Waleed99i/chipathon-2026-systolic-ip-core/README.md

# RTL-to-GDSII Design of a Configurable Matrix Accelerator IP on GF180MCU










## Overview

This project implements a configurable **NxN systolic matrix accelerator IP** targeting **GF180MCU**, following a complete **RTL-to-GDSII** design flow. The architecture consists of modular **Processing Elements (PEs)** built around an **approximate logarithmic MAC unit** to improve hardware efficiency.

The current design uses **FP16 inputs**, performs approximate floating-point multiplication, converts each product **directly to signed Q16.16**, and accumulates partial sums using a **32-bit Q16.16 accumulator**. The reusable RTL modules are parameterized, while the current ASIC implementation and physical verification cover a fixed **4×4 systolic array**. The approximate MAC has previously been demonstrated on the **Xilinx Nexys A7**; this is separate from validating the complete corrected ASIC implementation on FPGA.

---

## Design Specifications

| Specification | Details |
|---|---|
| Project Name | RTL-to-GDSII Design of a Configurable Matrix Accelerator IP on GF180MCU |
| Track | A |
| Team | A34 – SiliconForge |
| Target Technology | GlobalFoundries GF180MCU 180 nm, gf180mcuD |
| Hardware Description Language | Verilog / SystemVerilog |
| Target Flow | RTL verification → synthesis → physical design → block-level signoff → GDSII |
| Architecture | Parameterized RTL modules; current ASIC implementation fixed at 4×4 |
| Implemented Configuration | 4×4 Systolic Array |
| Compute Unit | Processing Element (PE) |
| Arithmetic Unit | Approximate Multiply-Accumulate (MAC) |
| Input Format | FP16 encoding (IEEE-754 half-precision format); arithmetic is approximate |
| Multiplier Output | FP16-encoded approximate logarithmic product |
| Converted Product | Signed Q16.16, converted directly from the FP16 product without an intermediate Q8.8 conversion |
| Accumulator / Result | Signed 32-bit Q16.16 |
| Interface | Fixed-cycle protocol: 8-bit input and 4-bit output; no external ready/valid handshake |
| Transaction Control | Reset before each matrix multiplication |
| Compute Schedule | 3N−2 = 10 internal compute events for N=4; not the complete external transaction latency |
| Clock Target | 45 ns (approximately 22.22 MHz) |
| FPGA Platform | Xilinx Nexys A7 — earlier approximate-MAC demonstration, separate from complete corrected-system validation |
| ASIC Top Cell | chip_core |
| Implemented Block Boundary | 1675 μm × 1675 μm; final shared-chip allocation subject to organizer confirmation |
| Logical Pad Definitions | 16 total: clock, reset, 8 inputs, 4 outputs, VDD and VSS; final package pin numbering pending |
| Optional Extension | Future work: lightweight open-source RISC-V integration |
---

## Project Goals

The primary objective of this project is to design a configurable systolic matrix accelerator IP capable of accelerating matrix multiplication workloads for machine learning and digital signal processing applications. The design emphasizes modularity, scalability, and hardware efficiency while following a complete ASIC design methodology.

Key design objectives include:

- Parameterized NxN systolic array architecture
- Modular Processing Element (PE) based design
- Approximate MAC implementation for reduced hardware complexity
- Fixed-cycle communication for the current chip wrapper; ready-valid interfacing remains a possible future extension
- RTL and gate-level verification, with earlier module-level FPGA demonstration
- Optional lightweight RISC-V integration
- OR integration with a ML Framework
- Tapeout-ready RTL targeting GF180MCU

---

# System Architecture

The accelerator consists of a parameterized systolic array built from Processing Elements (PEs). Each PE performs Multiply-Accumulate (MAC) operations while forwarding operands to neighboring PEs, enabling highly parallel matrix multiplication.

Current demonstrations are based on a **4×4 systolic array**, while the RTL is being developed to support configurable **NxN** array dimensions.

<div align="center">

**Top-Level Architecture**

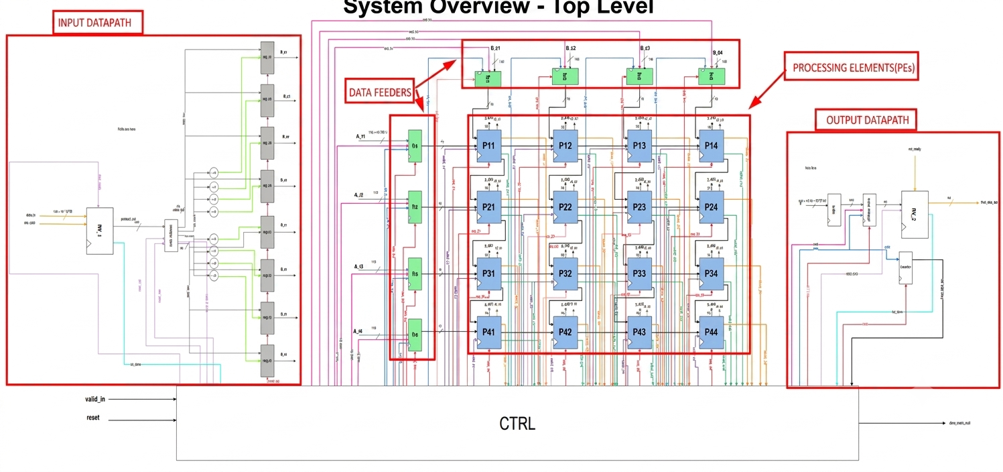
[picture p1: docs/systolic.png]
systolic


</div>

---

## Data Flow
```mermaid
flowchart TD

    A[Input Matrices A and B] --> B[Input Datapath]
    B --> C[Data Feeders]

    C --> D

    subgraph D["Parameterized NxN Systolic Array"]
        direction TB
        E[Processing Elements]
    end

    D --> F[Output Datapath]
    F --> G[Output Matrix]

    style A fill:#1e293b,stroke:#60a5fa,stroke-width:2px,color:#fff
    style B fill:#1e293b,stroke:#60a5fa,stroke-width:2px,color:#fff
    style C fill:#1e293b,stroke:#60a5fa,stroke-width:2px,color:#fff
    style D fill:#0f172a,stroke:#38bdf8,stroke-width:3px,color:#fff
    style E fill:#334155,stroke:#94a3b8,stroke-width:2px,color:#fff
    style F fill:#1e293b,stroke:#60a5fa,stroke-width:2px,color:#fff
    style G fill:#064e3b,stroke:#34d399,stroke-width:3px,color:#fff

    linkStyle default stroke:#64748b,stroke-width:2px
```

and will do integration afterwards with riscv core or ML framework

---
# Major Hardware Blocks

| Block | Inputs | Outputs | Description |
|---|---|---|---|
| **MAC Unit** | FP16, FP16 | Q16.16 | Performs approximate logarithmic multiplication on two FP16 operands, converts the product to fixed-point, and accumulates the result using a 32-bit Q16.16 accumulator. |
| **Processing Element (PE)** | FP16 activation, FP16 weight | FP16 activation, FP16 weight, Q16.16 partial sum | Core computational element of the systolic array. Each PE performs one MAC operation while forwarding activations and weights to neighboring PEs. |
| **Input Datapath** | **16 × 2N** | **16 × (2N-1)** | Accepts the external input stream, separates activations and weights, and prepares row and column data streams for the Data Feeders. |
| **Data Feeders** | **16 × (2N-1)** | **FP16 streams** | Aligns and schedules incoming operands with appropriate delays before injecting them into the systolic array. |
| **Chip Wrapper** | Clock, reset, 8-bit input | 4-bit output | Transfers input bytes and output nibbles on a fixed schedule, with no external ready/valid handshake. Reset is required before each matrix. |
| **Output Datapath** | **32 × (N × N)** | **64** | Collects the final outputs from every Processing Element and formats the result matrix for external transfer. |
| **Register** | Data, Clock, Reset | Registered Data | Pipeline register with reset logic and multiplexing support. Stores intermediate values between clock cycles. |
| **Counter** | Clock, Reset, done | valid_out | Controls the compute-event schedule using COUNT_MAX = 3N−2, which is 10 for N=4. This is an internal compute schedule, not the complete chip transaction latency. |

In Our Example N=4 since 4x4 systolic

---

# Chip Information

| Item | Value |
|---|---|
| Implemented Block | chip_core |
| Final Shared-Chip Allocation | Subject to organizer confirmation |
| Implemented Block Boundary | 1675 μm × 1675 μm |
| Logical Signal Pads | 14: clock, reset, 8 inputs and 4 outputs |
| Power/Ground Definitions | VDD and VSS |
| Package Pin Numbering | Pending final package and padframe |

---

# Pin Configuration

| Signal | Direction | Description |
|---|---|---|
| clk | Input | System clock |
| rst_n | Input | Active-low reset; reset before each matrix |
| input_in_0 … input_in_7 | Input | Eight-bit input data bus |
| output_out_0 … output_out_3 | Output function | Four-bit output bus, using bidirectional pad cells |
| VDD | Power | Block supply |
| VSS | Ground | Block ground |

See [info.yaml](info.yaml) for pad definitions and [TEST_PLAN.md](TEST_PLAN.md) for the verified fixed-cycle protocol.

---

# Interfacing

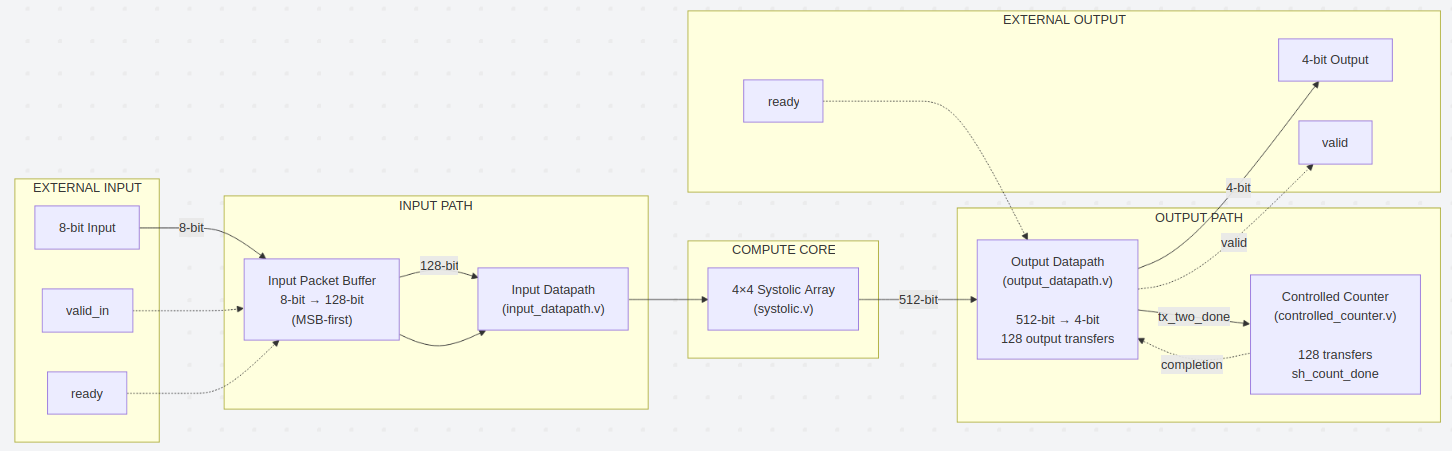
[picture p2: docs/Implementation/interfacing.png]
integration


---

# Design Flow

The development follows a structured hardware design methodology beginning from architecture definition and RTL implementation, progressing through verification and FPGA validation, and culminating in an ASIC RTL-to-GDSII flow targeting GF180MCU.

```mermaid
flowchart LR

    A[Architecture Design]
    B[RTL Development]
    C[Module Verification]
    D[System Integration]
    E[FPGA Validation]
    F[RTL Synthesis]
    G[Physical Design]
    H[Signoff Verification]
    I[GDSII Generation]

    A --> B
    B --> C
    C --> D
    D --> E
    E --> F
    F --> G
    G --> H
    H --> I

    A:::s1
    B:::s2
    C:::s3
    D:::s4
    E:::s5
    F:::s6
    G:::s7
    H:::s8
    I:::s9

    classDef s1 fill:#172554,stroke:#3b82f6,stroke-width:2px,color:#fff;
    classDef s2 fill:#1e3a8a,stroke:#60a5fa,stroke-width:2px,color:#fff;
    classDef s3 fill:#312e81,stroke:#818cf8,stroke-width:2px,color:#fff;
    classDef s4 fill:#4c1d95,stroke:#a78bfa,stroke-width:2px,color:#fff;
    classDef s5 fill:#581c87,stroke:#c084fc,stroke-width:2px,color:#fff;
    classDef s6 fill:#701a75,stroke:#e879f9,stroke-width:2px,color:#fff;
    classDef s7 fill:#831843,stroke:#f472b6,stroke-width:2px,color:#fff;
    classDef s8 fill:#9f1239,stroke:#fb7185,stroke-width:2px,color:#fff;
    classDef s9 fill:#064e3b,stroke:#34d399,stroke-width:3px,color:#fff;

    linkStyle default stroke:#94a3b8,stroke-width:2px;
```

---

# Development Roadmap

The project follows a structured four-phase implementation strategy, progressing from RTL development to ASIC implementation.

| Phase | Objectives | Status |
|---|---|---|
| **Phase 1** | Approximate MAC, Processing Element (PE), Parameterized Systolic Array RTL, Functional Verification | Completed |
| **Phase 2** | Input/Output Datapaths, Data Feeders, Fixed-Cycle Chip Wrapper, System Integration | Completed |
| **Phase 3** | FPGA Synthesis & Validation, Performance Optimization | In Progress |
| **Phase 4** | Corrected block implementation and verification completed; shared-chip integration/fabrication | In Progress | 

---

# Current Progress

A detailed project tracker is available here:

[Progress Tracker](https://docs.google.com/spreadsheets/d/1-T_ZC2E8IlozA7BDgOPqUjp5dZac3WXzmJ67Tr54c2c/edit?usp=sharing)

---
# Chip_core - Overall RTL Breakdown

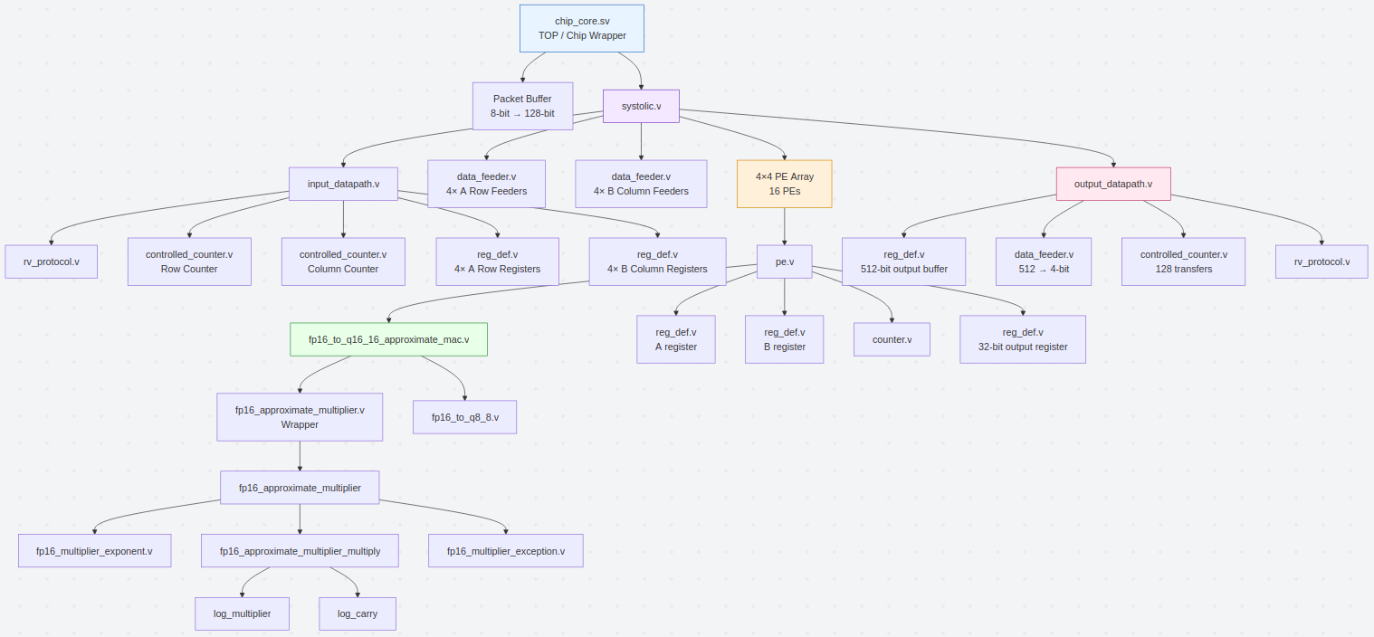
[picture p3: docs/chip_core.png]
chip_core


---

# Success Metrics

The project will be considered successful upon meeting the following objectives.

| Metric | Target |
|---|---|
| Functional Correctness | Complete matrix multiplication verified through simulation and FPGA validation |
| Frequency | Meet timing for the target GF180MCU implementation |
| Area | Current implemented boundary: **1675 μm × 1675 μm**; final shared-chip allocation subject to organizer confirmation |
| Throughput | Sustain one MAC operation per Processing Element per clock after pipeline fill |
| Scalability | Support parameterized NxN systolic arrays |
| FPGA Validation | Successful implementation on Xilinx Nexys A7 |
| ASIC Flow | Successful RTL-to-GDSII implementation using GF180MCU |

---

# FPGA Validation

The Approximate MAC architecture has been synthesized and validated on the **Xilinx Nexys A7 FPGA**.

Future FPGA validation includesComplete Synthesis of Systolic Array

---

# ASIC Design Flow

The project targets a complete RTL-to-GDSII implementation using the **GF180MCU** technology.

The completed block-level backend flow includes:

- RTL Synthesis
- Static Timing Analysis
- Floorplanning
- Power Planning
- Placement
- Clock Tree Synthesis
- Routing
- DRC
- LVS
- Signoff
- GDSII Generation
---

# Physical Design Results

The corrected 4×4 accelerator was implemented using **LibreLane 3.0.0** on the **GF180MCU 180 nm process (gf180mcuD)**. The implementation includes the counter and input-datapath corrections, direct FP16-to-Q16.16 product conversion, and a seven-cell physical engineering change order (ECO).

## Current Block-Level Signoff: chip_core

| Metric | Result |
|---|---|
| Clock period | 45 ns (approximately 22.22 MHz) |
| Setup timing | 0 violations across all 9 analyzed corners; worst setup slack **+0.5499 ns** |
| Hold timing | 0 violations across all 9 analyzed corners; worst hold slack **+0.0912 ns** |
| DRC | Pass: 0 reported errors in Magic and KLayout |
| LVS | Pass: layout and powered netlist match |
| Antenna | Pass: 0 reported violations |
| Max slew violations | 0 across all 9 analyzed corners |
| Max fanout violations | 0 across all 9 analyzed corners |
| Max capacitance violations | 0 across all 9 analyzed corners |
| Block boundary | 1675 μm × 1675 μm |
| Standard-cell instance area | Approximately 0.987 mm² |
| Standard-cell utilization | Approximately 36.17% |

The seven-cell ECO cleared the remaining slew and capacitance violations. Placement legalization, routing, parasitic extraction and block-level signoff checks were rerun after the cell changes.

Reproducibility was verified in two stages: an RTL-to-checkpoint rebuild produced a byte-identical checkpoint, and a checkpoint-to-GDS replay reproduced the powered netlist byte-for-byte and the GDS polygon geometry and labels across all 27 layers. GDS file bytes differed.

These are pre-silicon, block-level results under the recorded constraints and tool/PDK environment. 

## Early Flow Validation (Workshop/Padring Baseline)

Before integrating the real accelerator, the LibreLane/GF180MCU toolchain was validated end-to-end on a placeholder design:

| Clock Period | Frequency | DRC | LVS | Setup Slack (worst corner) |
|---|---|---|---|---|
| 40ns | 25 MHz |  Pass |  Pass | — |
| 30ns | 33 MHz |  Pass |  Pass | +13.99ns |

These results validate the tool/PDK flow only; they are not timing results for the integrated accelerator (see Current Block-Level Signoff above).

## Test Plan and Reproducibility

- [Silicon test plan](TEST_PLAN.md): fixed-cycle pin timing, bring-up tests, pass/fail criteria, equipment requirements and publication of measured results.
- [Pin-level verification](test/sim_results/20261031_095426/SUMMARY.txt): 93 matrix transactions passed on both RTL and the final gate-level netlist, with zero mismatches. Deliberately incorrect vectors were detected.
- [Reproduction guide](reproduce/README.md): the RTL-to-checkpoint rebuild produced a byte-identical checkpoint. The checkpoint-to-GDS replay produced a byte-identical powered netlist and matching GDS geometry and labels across all 27 layers.

The two reproduction stages used the existing Nix environment and local PDK. Independent tool/PDK installation has not been demonstrated. Approximate arithmetic, finite numerical range and reset-per-matrix operation remain documented limitations.

## Submission
`info.yaml` and `lvs_config.json` reference the final `chip_core` design. GDS output (45ns, fully timing-closed, DRC/LVS/Antenna clean) is included at `gds/chip_core.gds`.

---

# Resources Links
[Github Repository](https://github.com/Waleed99i/chipathon-2026-systolic-ip-core)

[Padring Proposal Slide Link](https://docs.google.com/presentation/d/1hGlZvZFFLWlx8hJLkmKaFUCYW1uyk7dkF3z44zS5dTQ/edit?usp=sharing)

[Proposal Slide Link](https://docs.google.com/presentation/d/1u3HMhi0KsbPWeEo2SdxVy66h3A2EKqcJ1DBfrJLO6gw/edit?usp=sharing)

[Detailed Proposal Link](https://docs.google.com/document/d/1xj1mtmIwVFShTZUq7PKGKg6W1PffVR4_vp0zMOgc8iE/edit?usp=sharing)

[Pin Requirements Link](https://docs.google.com/spreadsheets/d/1KH9oZjetv38rxIAL1lnZPNvuW3Qhh9-GSiZVkqRqzDc/edit?usp=sharing)

[Progress Tracker](https://docs.google.com/spreadsheets/d/1-T_ZC2E8IlozA7BDgOPqUjp5dZac3WXzmJ67Tr54c2c/edit?usp=sharing)

[Propsal Presentation Video Link](https://youtu.be/i-fauhB5LK8)

[schematic Review Slides (Extended) Link](https://docs.google.com/presentation/d/1XbPeDPZbSCVIkTJ6YJzha1Qlfp463J90a_zdM6emGkA/edit?usp=sharing)

[Schematic Review Slides (Abbreviated) Link](https://docs.google.com/presentation/d/1Jb6dxnFrmxyFip32HSGO6qTabfnJVp7GGHKu2foIoVM/edit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)

[Schematic Review Presentation Video Link](https://youtu.be/ZGd18GQEK7I?si=cJApcDfwtI_DK_bS)

[Layout Review slide Link](https://docs.google.com/presentation/d/1ikT-gyHuk3Rm3eCD9rJ-7HMOGe7eNcvOWRMagcxCcSo/edit?usp=sharing)

[Layout Review Presentation Video Link](https://drive.google.com/file/d/1sBQsk-xMmFBTl1YXC0w8MSAxI7oVKdcV/view?usp=drive_link)

---

# Team

| Member | GitHub | Discord | Affiliation | Role |
|---|---|---|---|---|
| Muhammad Waleed Akram | [@Waleed99i](https://github.com/Waleed99i) | `waleed_07` | University of Engineering and Technology, Lahore (Undergraduate) | Team Lead |
| Abdul Muiz | [@abdmz162](https://github.com/abdmz162) | `abdmz` | University of Engineering and Technology, Lahore (Undergraduate) | RTL Designer |
| Rumali Siddiqua | [@Rumali-Siddiqua](https://github.com/Rumali-Siddiqua) | `rumali24` | University of Virginia, USA (PhD Student) | Physical Designer |
| Nur Cahyo Ihsan Prastyawan | [@cprastyawan](https://github.com/cprastyawan) | `chyp2640` | Universitas Gadjah Mada, Indonesia (Master's Graduate) | RTL Designer |

---

# License

This project is licensed under the Apache License 2.0.

See the **LICENSE** file for details.
