Waleed99i/chipathon-2026-systolic-ip-core/Project Proposal/phased_implementation.md

We have divided our proposed implementation into below 4 phases : 

### Phase 1: Core Systolic Array
- Design of MAC and Processing Element (PE)
- Parameterized systolic array implementation
- RTL development and modular architecture
- Testbench development and verification

### Phase 2: Memory and Integration
- SRAM buffering system
- Streaming and data movement architecture
- Integration of control logic and datapath

### Phase 3: FPGA and Optimization
- FPGA synthesis and deployment
- Performance and timing analysis
- Initial optimization techniques

### Phase 4: ASIC Backend Flow
- RTL-to-GDSII implementation
- Floorplanning and placement
- Clock tree synthesis and routing
- Timing closure and signoff preparation
- Tapeout readiness exploration
