Waleed99i/chipathon-2026-systolic-ip-core/signoff/q16_eco_full4/run_reports/final/metrics.csv

Metric | Value
design__instance__displacement__total | 35.84
design__instance__displacement__mean | 0.0005
design__instance__displacement__max | 9.52
route__wirelength__estimated | 1.34462E+6
design__violations | 0
design__io | 72
design__die__area | 2.80562E+6
design__core__area | 2.72901E+6
design__instance__count | 119247
design__instance__area | 2.72901E+6
design__instance__count__stdcell | 52630
design__instance__area__stdcell | 987181
design__instance__count__macros | 0
design__instance__area__macros | 0
design__instance__count__padcells | 0
design__instance__area__padcells | 0
design__instance__count__cover | 0
design__instance__area__cover | 0
design__instance__utilization | 0.361736
design__instance__utilization__stdcell | 0.361736
design__rows | 419
design__rows:GF018hv5v_mcu_sc7 | 419
design__sites | 1243173
design__sites:GF018hv5v_mcu_sc7 | 1243173
design__instance__count__class:endcap_cell | 838
design__instance__area__class:endcap_cell | 3679.16
design__instance__count__class:tap_cell | 17688
design__instance__area__class:tap_cell | 77657.4
design__instance__count__class:antenna_cell | 14
design__instance__area__class:antenna_cell | 61.4656
design__instance__count__class:tie_cell | 52
design__instance__area__class:tie_cell | 456.602
design__instance__count__class:clock_buffer | 1060
design__instance__area__class:clock_buffer | 48777.3
design__instance__count__class:timing_repair_buffer | 4878
design__instance__area__class:timing_repair_buffer | 132371
design__instance__count__class:inverter | 2170
design__instance__area__class:inverter | 19142.1
design__instance__count__class:clock_inverter | 84
design__instance__area__class:clock_inverter | 1356.63
design__instance__count__class:sequential_cell | 4096
design__instance__area__class:sequential_cell | 288601
design__instance__count__class:multi_input_combinational_cell | 21750
design__instance__area__class:multi_input_combinational_cell | 415079
flow__warnings__count | 1
flow__errors__count | 0
flow__warnings__count:ORD-2001 | 1
flow__warnings__type_count | 1
design__max_slew_violation__count__corner:nom_tt_025C_5v00 | 0
design__max_fanout_violation__count__corner:nom_tt_025C_5v00 | 0
design__max_cap_violation__count__corner:nom_tt_025C_5v00 | 0
power__internal__total | 0.1038675308227539
power__switching__total | 0.03214292228221893
power__leakage__total | 0.000012093365512555465
power__total | 0.13602255284786224
clock__skew__worst_hold__corner:nom_tt_025C_5v00 | -0.5598430766323693
clock__skew__worst_setup__corner:nom_tt_025C_5v00 | 0.5658276229935633
timing__hold__ws__corner:nom_tt_025C_5v00 | 0.2871001295741329
timing__setup__ws__corner:nom_tt_025C_5v00 | 18.819042856719385
timing__hold__tns__corner:nom_tt_025C_5v00 | 0.0
timing__setup__tns__corner:nom_tt_025C_5v00 | 0.0
timing__hold__wns__corner:nom_tt_025C_5v00 | 0
timing__setup__wns__corner:nom_tt_025C_5v00 | 0.0
timing__hold_vio__count__corner:nom_tt_025C_5v00 | 0
timing__hold_r2r__ws__corner:nom_tt_025C_5v00 | 0.287100
timing__hold_r2r_vio__count__corner:nom_tt_025C_5v00 | 0
timing__setup_vio__count__corner:nom_tt_025C_5v00 | 0
timing__setup_r2r__ws__corner:nom_tt_025C_5v00 | 21.393702
timing__setup_r2r_vio__count__corner:nom_tt_025C_5v00 | 0
flow__warnings__count:EST-0026 | 15
design__max_slew_violation__count | 0
design__max_fanout_violation__count | 0
design__max_cap_violation__count | 0
clock__skew__worst_hold | -0.4476421304780765
clock__skew__worst_setup | 0.4497588817566926
timing__hold__ws | 0.09115441992566169
timing__setup__ws | 0.5498535116188729
timing__hold__tns | 0.0
timing__setup__tns | 0.0
timing__hold__wns | 0
timing__setup__wns | 0.0
timing__hold_vio__count | 0
timing__hold_r2r__ws | 0.091154
timing__hold_r2r_vio__count | 0
timing__setup_vio__count | 0
timing__setup_r2r__ws | 0.549854
timing__setup_r2r_vio__count | 0
global_route__vias | 19
global_route__wirelength | 2175969
antenna__violating__nets | 0
antenna__violating__pins | 0
route__antenna_violation__count | 0
antenna_diodes_count | 12
route__net | 33613
route__net__special | 2
route__drc_errors__iter:0 | 10
route__wirelength__iter:0 | 1437134
route__drc_errors__iter:1 | 0
route__wirelength__iter:1 | 1437128
route__drc_errors__iter:2 | 21
route__wirelength__iter:2 | 1437202
route__drc_errors__iter:3 | 0
route__wirelength__iter:3 | 1437123
route__drc_errors__iter:4 | 11
route__wirelength__iter:4 | 1437154
route__drc_errors__iter:5 | 11
route__wirelength__iter:5 | 1437154
route__drc_errors__iter:6 | 9
route__wirelength__iter:6 | 1437155
route__drc_errors__iter:7 | 9
route__wirelength__iter:7 | 1437150
route__drc_errors__iter:8 | 9
route__wirelength__iter:8 | 1437159
route__drc_errors__iter:10 | 9
route__wirelength__iter:10 | 1437158
route__drc_errors__iter:11 | 9
route__wirelength__iter:11 | 1437155
route__drc_errors__iter:15 | 9
route__wirelength__iter:15 | 1437159
route__drc_errors__iter:16 | 9
route__wirelength__iter:16 | 1437162
route__drc_errors__iter:17 | 19
route__wirelength__iter:17 | 1437152
route__drc_errors__iter:18 | 12
route__wirelength__iter:18 | 1437153
route__drc_errors__iter:19 | 12
route__wirelength__iter:19 | 1437154
route__drc_errors__iter:20 | 12
route__wirelength__iter:20 | 1437159
route__drc_errors__iter:21 | 7
route__wirelength__iter:21 | 1437157
route__drc_errors__iter:22 | 7
route__wirelength__iter:22 | 1437158
route__drc_errors__iter:23 | 7
route__wirelength__iter:23 | 1437158
route__drc_errors__iter:24 | 7
route__wirelength__iter:24 | 1437158
route__drc_errors__iter:25 | 17
route__wirelength__iter:25 | 1437155
route__drc_errors__iter:26 | 10
route__wirelength__iter:26 | 1437158
route__drc_errors__iter:27 | 10
route__wirelength__iter:27 | 1437158
route__drc_errors__iter:28 | 1
route__wirelength__iter:28 | 1437150
route__drc_errors__iter:29 | 1
route__wirelength__iter:29 | 1437146
route__drc_errors__iter:30 | 0
route__wirelength__iter:30 | 1437146
route__drc_errors | 0
route__wirelength | 1437128
route__vias | 211229
route__vias__singlecut | 211229
route__vias__multicut | 0
flow__warnings__count:DRT-0349 | 8
design__disconnected_pin__count | 4
design__critical_disconnected_pin__count | 0
flow__warnings__count:ORD-0039 | 1
route__wirelength__max | 1257.62
design__instance__count__class:fill_cell | 66617
design__instance__area__class:fill_cell | 1.74183E+6
timing__unannotated_net__count__corner:nom_tt_025C_5v00 | 495
timing__unannotated_net_filtered__count__corner:nom_tt_025C_5v00 | 0
design__max_slew_violation__count__corner:nom_ss_125C_4v50 | 0
design__max_fanout_violation__count__corner:nom_ss_125C_4v50 | 0
design__max_cap_violation__count__corner:nom_ss_125C_4v50 | 0
clock__skew__worst_hold__corner:nom_ss_125C_4v50 | -0.8046048499650114
clock__skew__worst_setup__corner:nom_ss_125C_4v50 | 0.8146124005920153
timing__hold__ws__corner:nom_ss_125C_4v50 | 0.7057741257853857
timing__setup__ws__corner:nom_ss_125C_4v50 | 1.2720314051016304
timing__hold__tns__corner:nom_ss_125C_4v50 | 0.0
timing__setup__tns__corner:nom_ss_125C_4v50 | 0.0
timing__hold__wns__corner:nom_ss_125C_4v50 | 0
timing__setup__wns__corner:nom_ss_125C_4v50 | 0.0
timing__hold_vio__count__corner:nom_ss_125C_4v50 | 0
timing__hold_r2r__ws__corner:nom_ss_125C_4v50 | 0.705774
timing__hold_r2r_vio__count__corner:nom_ss_125C_4v50 | 0
timing__setup_vio__count__corner:nom_ss_125C_4v50 | 0
timing__setup_r2r__ws__corner:nom_ss_125C_4v50 | 1.272031
timing__setup_r2r_vio__count__corner:nom_ss_125C_4v50 | 0
timing__unannotated_net__count__corner:nom_ss_125C_4v50 | 495
timing__unannotated_net_filtered__count__corner:nom_ss_125C_4v50 | 0
design__max_slew_violation__count__corner:nom_ff_n40C_5v50 | 0
design__max_fanout_violation__count__corner:nom_ff_n40C_5v50 | 0
design__max_cap_violation__count__corner:nom_ff_n40C_5v50 | 0
clock__skew__worst_hold__corner:nom_ff_n40C_5v50 | -0.4515758728101822
clock__skew__worst_setup__corner:nom_ff_n40C_5v50 | 0.45477131681003163
timing__hold__ws__corner:nom_ff_n40C_5v50 | 0.09316636614778911
timing__setup__ws__corner:nom_ff_n40C_5v50 | 25.393261545570383
timing__hold__tns__corner:nom_ff_n40C_5v50 | 0.0
timing__setup__tns__corner:nom_ff_n40C_5v50 | 0.0
timing__hold__wns__corner:nom_ff_n40C_5v50 | 0
timing__setup__wns__corner:nom_ff_n40C_5v50 | 0.0
timing__hold_vio__count__corner:nom_ff_n40C_5v50 | 0
timing__hold_r2r__ws__corner:nom_ff_n40C_5v50 | 0.093166
timing__hold_r2r_vio__count__corner:nom_ff_n40C_5v50 | 0
timing__setup_vio__count__corner:nom_ff_n40C_5v50 | 0
timing__setup_r2r__ws__corner:nom_ff_n40C_5v50 | 30.448641
timing__setup_r2r_vio__count__corner:nom_ff_n40C_5v50 | 0
timing__unannotated_net__count__corner:nom_ff_n40C_5v50 | 495
timing__unannotated_net_filtered__count__corner:nom_ff_n40C_5v50 | 0
design__max_slew_violation__count__corner:min_tt_025C_5v00 | 0
design__max_fanout_violation__count__corner:min_tt_025C_5v00 | 0
design__max_cap_violation__count__corner:min_tt_025C_5v00 | 0
clock__skew__worst_hold__corner:min_tt_025C_5v00 | -0.5558125228497782
clock__skew__worst_setup__corner:min_tt_025C_5v00 | 0.558321182867171
timing__hold__ws__corner:min_tt_025C_5v00 | 0.28394132293513225
timing__setup__ws__corner:min_tt_025C_5v00 | 19.424050473404662
timing__hold__tns__corner:min_tt_025C_5v00 | 0.0
timing__setup__tns__corner:min_tt_025C_5v00 | 0.0
timing__hold__wns__corner:min_tt_025C_5v00 | 0
timing__setup__wns__corner:min_tt_025C_5v00 | 0.0
timing__hold_vio__count__corner:min_tt_025C_5v00 | 0
timing__hold_r2r__ws__corner:min_tt_025C_5v00 | 0.283941
timing__hold_r2r_vio__count__corner:min_tt_025C_5v00 | 0
timing__setup_vio__count__corner:min_tt_025C_5v00 | 0
timing__setup_r2r__ws__corner:min_tt_025C_5v00 | 21.750294
timing__setup_r2r_vio__count__corner:min_tt_025C_5v00 | 0
timing__unannotated_net__count__corner:min_tt_025C_5v00 | 495
timing__unannotated_net_filtered__count__corner:min_tt_025C_5v00 | 0
design__max_slew_violation__count__corner:min_ss_125C_4v50 | 0
design__max_fanout_violation__count__corner:min_ss_125C_4v50 | 0
design__max_cap_violation__count__corner:min_ss_125C_4v50 | 0
clock__skew__worst_hold__corner:min_ss_125C_4v50 | -0.7981837638981886
clock__skew__worst_setup__corner:min_ss_125C_4v50 | 0.8018936852621997
timing__hold__ws__corner:min_ss_125C_4v50 | 0.700570288277188
timing__setup__ws__corner:min_ss_125C_4v50 | 1.7366553131556215
timing__hold__tns__corner:min_ss_125C_4v50 | 0.0
timing__setup__tns__corner:min_ss_125C_4v50 | 0.0
timing__hold__wns__corner:min_ss_125C_4v50 | 0
timing__setup__wns__corner:min_ss_125C_4v50 | 0.0
timing__hold_vio__count__corner:min_ss_125C_4v50 | 0
timing__hold_r2r__ws__corner:min_ss_125C_4v50 | 0.700570
timing__hold_r2r_vio__count__corner:min_ss_125C_4v50 | 0
timing__setup_vio__count__corner:min_ss_125C_4v50 | 0
timing__setup_r2r__ws__corner:min_ss_125C_4v50 | 1.736655
timing__setup_r2r_vio__count__corner:min_ss_125C_4v50 | 0
timing__unannotated_net__count__corner:min_ss_125C_4v50 | 495
timing__unannotated_net_filtered__count__corner:min_ss_125C_4v50 | 0
design__max_slew_violation__count__corner:min_ff_n40C_5v50 | 0
design__max_fanout_violation__count__corner:min_ff_n40C_5v50 | 0
design__max_cap_violation__count__corner:min_ff_n40C_5v50 | 0
clock__skew__worst_hold__corner:min_ff_n40C_5v50 | -0.4476421304780765
clock__skew__worst_setup__corner:min_ff_n40C_5v50 | 0.4497588817566926
timing__hold__ws__corner:min_ff_n40C_5v50 | 0.09115441992566169
timing__setup__ws__corner:min_ff_n40C_5v50 | 25.799576538721972
timing__hold__tns__corner:min_ff_n40C_5v50 | 0.0
timing__setup__tns__corner:min_ff_n40C_5v50 | 0.0
timing__hold__wns__corner:min_ff_n40C_5v50 | 0
timing__setup__wns__corner:min_ff_n40C_5v50 | 0.0
timing__hold_vio__count__corner:min_ff_n40C_5v50 | 0
timing__hold_r2r__ws__corner:min_ff_n40C_5v50 | 0.091154
timing__hold_r2r_vio__count__corner:min_ff_n40C_5v50 | 0
timing__setup_vio__count__corner:min_ff_n40C_5v50 | 0
timing__setup_r2r__ws__corner:min_ff_n40C_5v50 | 30.643335
timing__setup_r2r_vio__count__corner:min_ff_n40C_5v50 | 0
timing__unannotated_net__count__corner:min_ff_n40C_5v50 | 495
timing__unannotated_net_filtered__count__corner:min_ff_n40C_5v50 | 0
design__max_slew_violation__count__corner:max_tt_025C_5v00 | 0
design__max_fanout_violation__count__corner:max_tt_025C_5v00 | 0
design__max_cap_violation__count__corner:max_tt_025C_5v00 | 0
clock__skew__worst_hold__corner:max_tt_025C_5v00 | -0.5662390716581259
clock__skew__worst_setup__corner:max_tt_025C_5v00 | 0.5746183691511645
timing__hold__ws__corner:max_tt_025C_5v00 | 0.2908171563657026
timing__setup__ws__corner:max_tt_025C_5v00 | 18.10364709384127
timing__hold__tns__corner:max_tt_025C_5v00 | 0.0
timing__setup__tns__corner:max_tt_025C_5v00 | 0.0
timing__hold__wns__corner:max_tt_025C_5v00 | 0
timing__setup__wns__corner:max_tt_025C_5v00 | 0.0
timing__hold_vio__count__corner:max_tt_025C_5v00 | 0
timing__hold_r2r__ws__corner:max_tt_025C_5v00 | 0.290817
timing__hold_r2r_vio__count__corner:max_tt_025C_5v00 | 0
timing__setup_vio__count__corner:max_tt_025C_5v00 | 0
timing__setup_r2r__ws__corner:max_tt_025C_5v00 | 20.966507
timing__setup_r2r_vio__count__corner:max_tt_025C_5v00 | 0
timing__unannotated_net__count__corner:max_tt_025C_5v00 | 495
timing__unannotated_net_filtered__count__corner:max_tt_025C_5v00 | 0
design__max_slew_violation__count__corner:max_ss_125C_4v50 | 0
design__max_fanout_violation__count__corner:max_ss_125C_4v50 | 0
design__max_cap_violation__count__corner:max_ss_125C_4v50 | 0
clock__skew__worst_hold__corner:max_ss_125C_4v50 | -0.8128729031078363
clock__skew__worst_setup__corner:max_ss_125C_4v50 | 0.829850878169784
timing__hold__ws__corner:max_ss_125C_4v50 | 0.711956291850552
timing__setup__ws__corner:max_ss_125C_4v50 | 0.5498535116188729
timing__hold__tns__corner:max_ss_125C_4v50 | 0.0
timing__setup__tns__corner:max_ss_125C_4v50 | 0.0
timing__hold__wns__corner:max_ss_125C_4v50 | 0
timing__setup__wns__corner:max_ss_125C_4v50 | 0.0
timing__hold_vio__count__corner:max_ss_125C_4v50 | 0
timing__hold_r2r__ws__corner:max_ss_125C_4v50 | 0.711956
timing__hold_r2r_vio__count__corner:max_ss_125C_4v50 | 0
timing__setup_vio__count__corner:max_ss_125C_4v50 | 0
timing__setup_r2r__ws__corner:max_ss_125C_4v50 | 0.549854
timing__setup_r2r_vio__count__corner:max_ss_125C_4v50 | 0
timing__unannotated_net__count__corner:max_ss_125C_4v50 | 495
timing__unannotated_net_filtered__count__corner:max_ss_125C_4v50 | 0
design__max_slew_violation__count__corner:max_ff_n40C_5v50 | 0
design__max_fanout_violation__count__corner:max_ff_n40C_5v50 | 0
design__max_cap_violation__count__corner:max_ff_n40C_5v50 | 0
clock__skew__worst_hold__corner:max_ff_n40C_5v50 | -0.45619573299091093
clock__skew__worst_setup__corner:max_ff_n40C_5v50 | 0.4608371314989266
timing__hold__ws__corner:max_ff_n40C_5v50 | 0.09556089523502256
timing__setup__ws__corner:max_ff_n40C_5v50 | 24.91069110386037
timing__hold__tns__corner:max_ff_n40C_5v50 | 0.0
timing__setup__tns__corner:max_ff_n40C_5v50 | 0.0
timing__hold__wns__corner:max_ff_n40C_5v50 | 0
timing__setup__wns__corner:max_ff_n40C_5v50 | 0.0
timing__hold_vio__count__corner:max_ff_n40C_5v50 | 0
timing__hold_r2r__ws__corner:max_ff_n40C_5v50 | 0.095561
timing__hold_r2r_vio__count__corner:max_ff_n40C_5v50 | 0
timing__setup_vio__count__corner:max_ff_n40C_5v50 | 0
timing__setup_r2r__ws__corner:max_ff_n40C_5v50 | 30.193577
timing__setup_r2r_vio__count__corner:max_ff_n40C_5v50 | 0
timing__unannotated_net__count__corner:max_ff_n40C_5v50 | 495
timing__unannotated_net_filtered__count__corner:max_ff_n40C_5v50 | 0
timing__unannotated_net__count | 495
timing__unannotated_net_filtered__count | 0
design_powergrid__voltage__worst__net:VDD__corner:nom_tt_025C_5v00 | 4.99919
design_powergrid__drop__average__net:VDD__corner:nom_tt_025C_5v00 | 4.99985
design_powergrid__drop__worst__net:VDD__corner:nom_tt_025C_5v00 | 0.000806911
design_powergrid__voltage__worst__net:VSS__corner:nom_tt_025C_5v00 | 0.000808328
design_powergrid__drop__average__net:VSS__corner:nom_tt_025C_5v00 | 0.000148739
design_powergrid__drop__worst__net:VSS__corner:nom_tt_025C_5v00 | 0.000808328
design_powergrid__voltage__worst | 0.000808328
design_powergrid__voltage__worst__net:VDD | 4.99919
design_powergrid__drop__worst | 0.000808328
design_powergrid__drop__worst__net:VDD | 0.000806911
design_powergrid__voltage__worst__net:VSS | 0.000808328
design_powergrid__drop__worst__net:VSS | 0.000808328
ir__voltage__worst | 5
ir__drop__avg | 0.00015200000000000000836830604811211742344312369823455810546875
ir__drop__worst | 0.0008069999999999999916455717396956970333121716976165771484375
design__xor_difference__count | 0
magic__drc_error__count | 0
klayout__drc_error__count | 0
magic__illegal_overlap__count | 0
design__lvs_device_difference__count | 0
design__lvs_net_difference__count | 0
design__lvs_property_fail__count | 0
design__lvs_error__count | 0
design__lvs_unmatched_device__count | 0
design__lvs_unmatched_net__count | 0
design__lvs_unmatched_pin__count | 0
