Waleed99i/chipathon-2026-systolic-ip-core/docs/simulations/counter.png

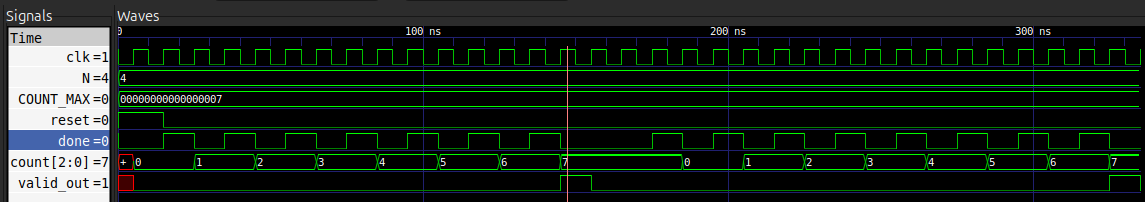
docs/simulations/counter.png
