Waleed99i/chipathon-2026-systolic-ip-core/docs/simulations/data_feeder.png

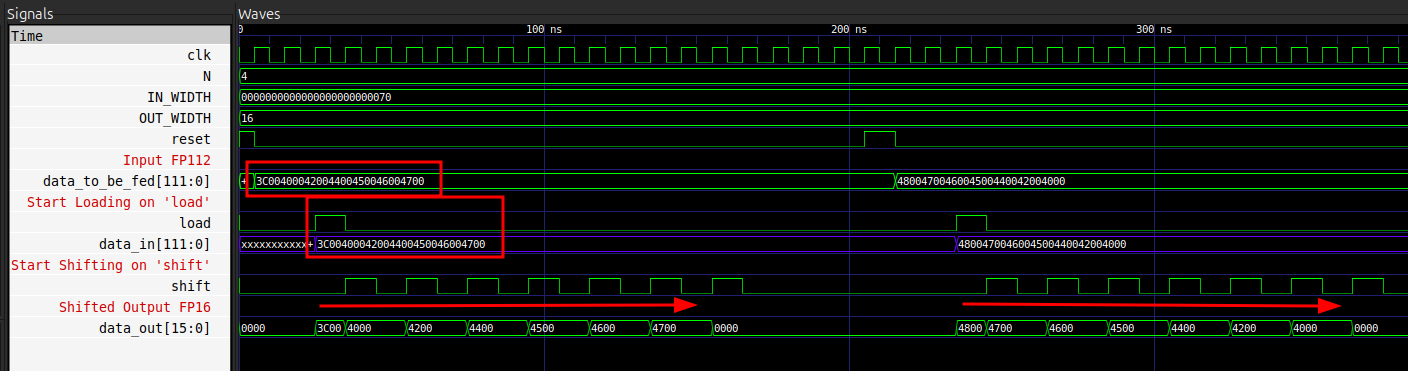
docs/simulations/data_feeder.png
