Waleed99i/chipathon-2026-systolic-ip-core/docs/simulations/input_datapath_explained.png

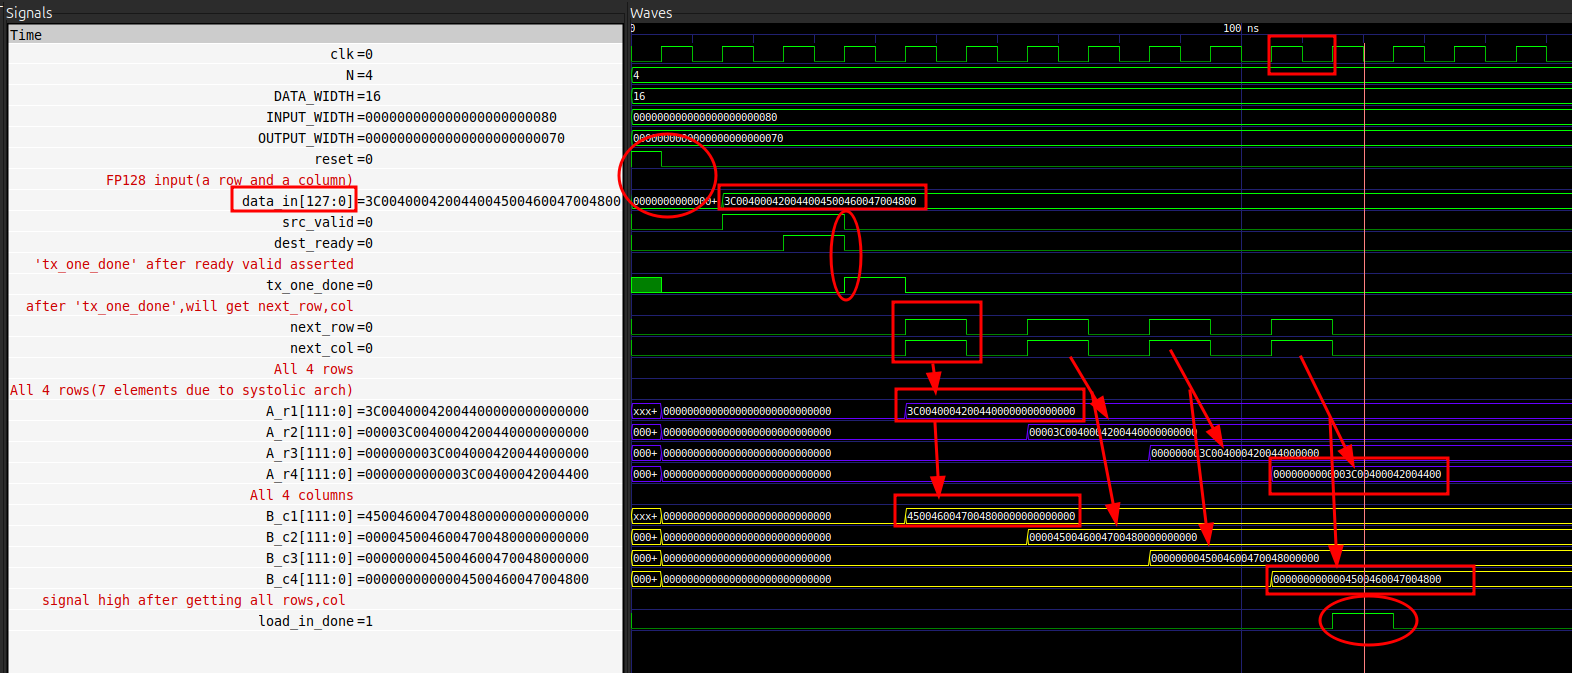
docs/simulations/input_datapath_explained.png
