Waleed99i/chipathon-2026-systolic-ip-core/docs/simulations/mac.png

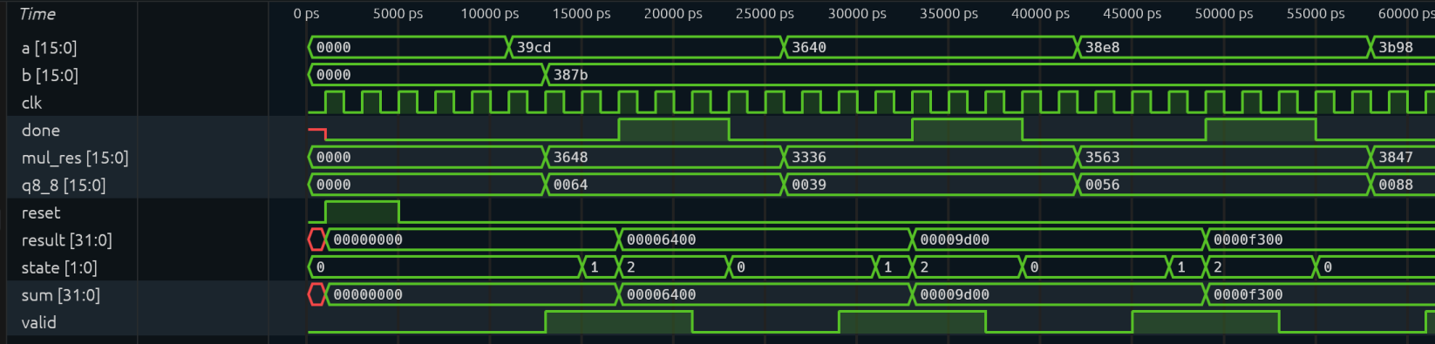
docs/simulations/mac.png
