Waleed99i/chipathon-2026-systolic-ip-core/docs/simulations/output_datapath.png

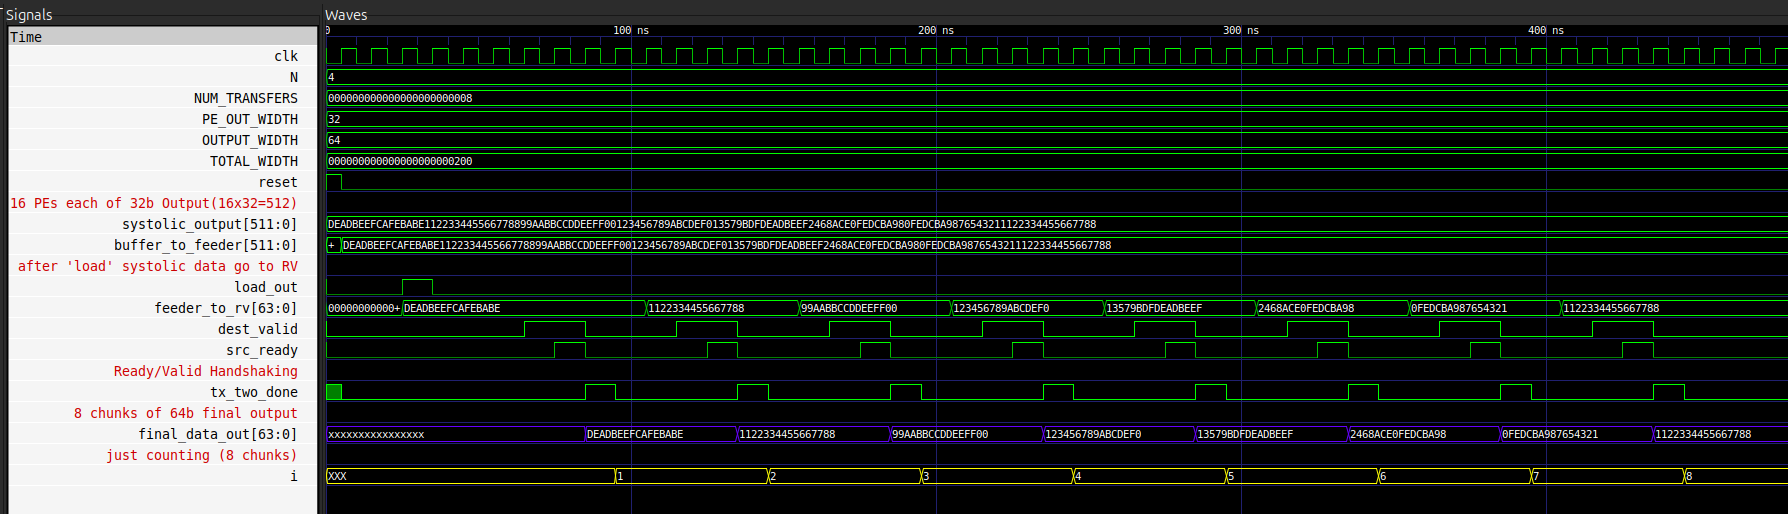
docs/simulations/output_datapath.png
