Waleed99i/chipathon-2026-systolic-ip-core/docs/simulations/output_datapath_explained.png

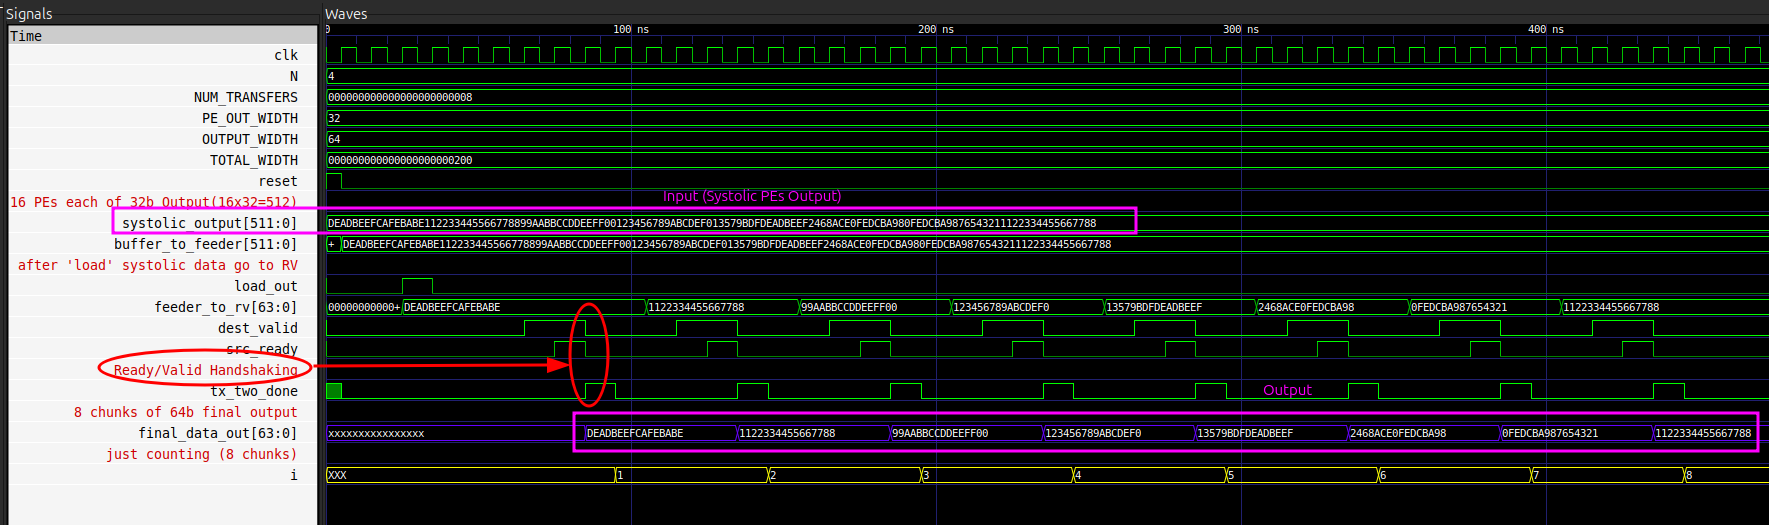
docs/simulations/output_datapath_explained.png
