Waleed99i/chipathon-2026-systolic-ip-core/docs/simulations/pe.png

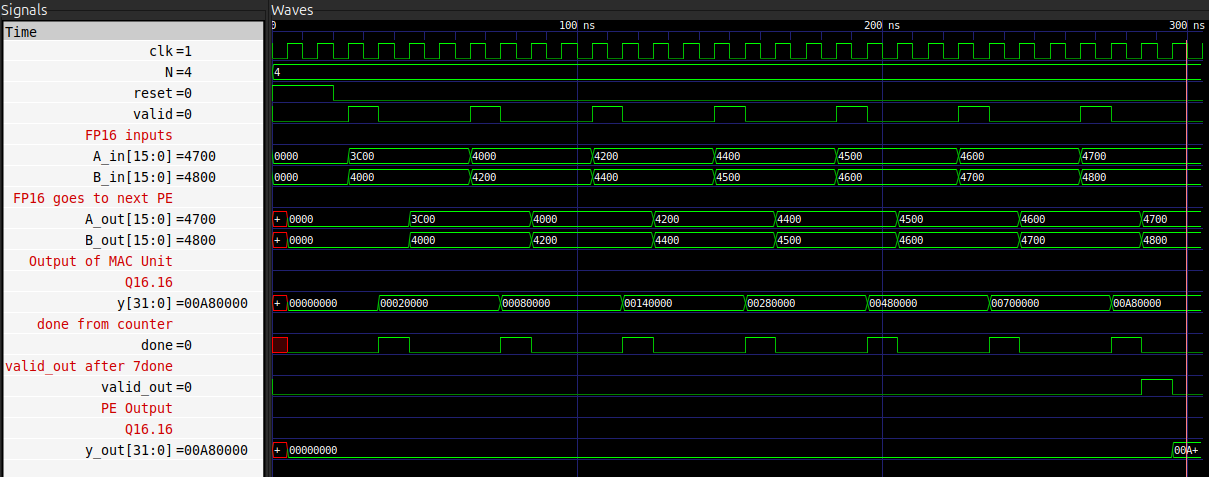
docs/simulations/pe.png
