Waleed99i/chipathon-2026-systolic-ip-core/docs/simulations/pe_explained.png

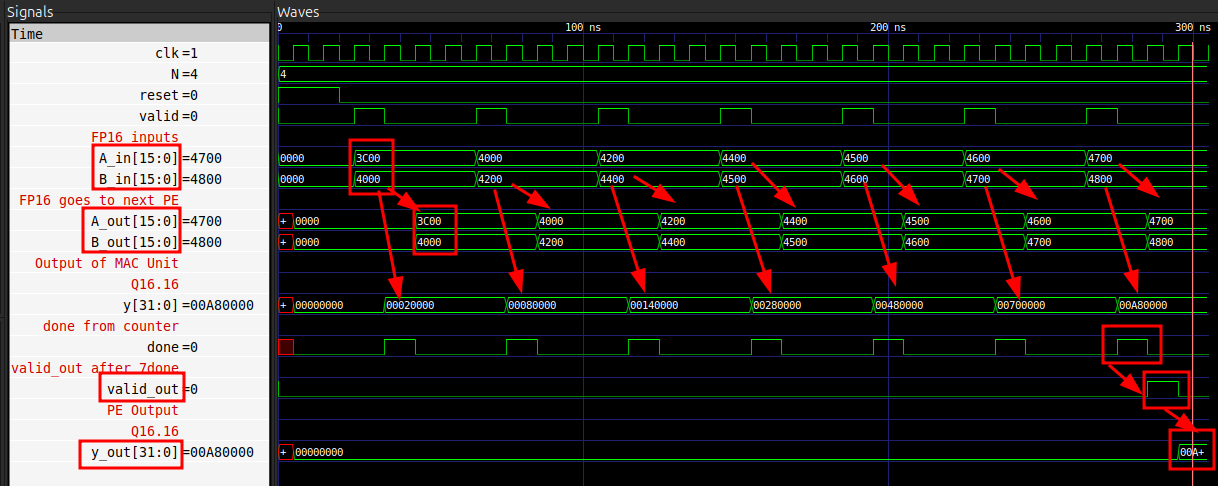
docs/simulations/pe_explained.png
