Waleed99i/chipathon-2026-systolic-ip-core/docs/simulations/rv_protocol.png

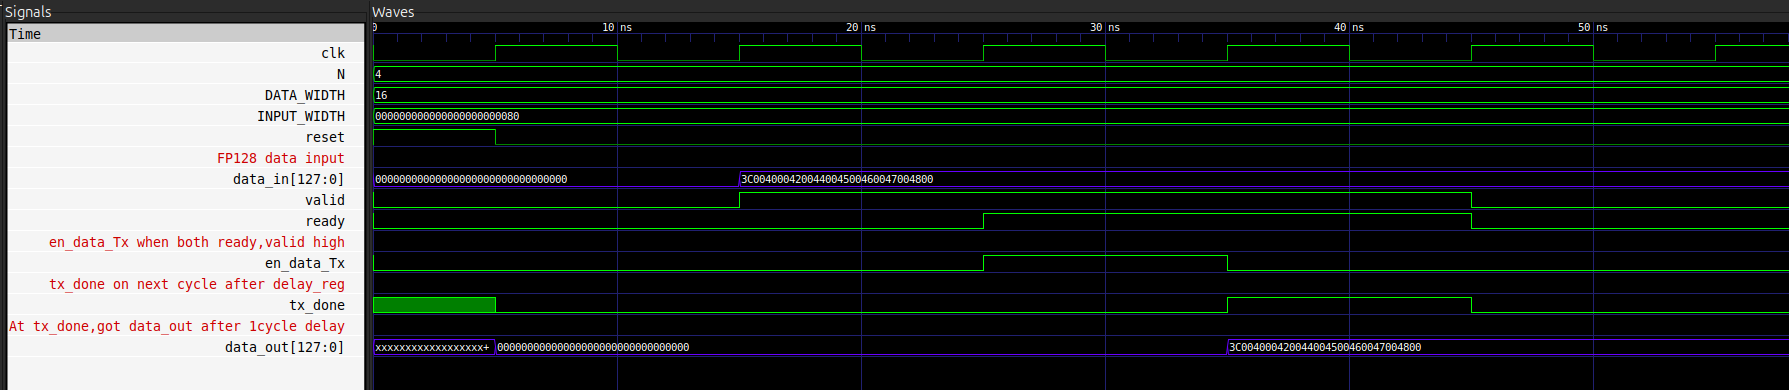
docs/simulations/rv_protocol.png
