Waleed99i/chipathon-2026-systolic-ip-core/docs/simulations/rv_protocol_explained.png

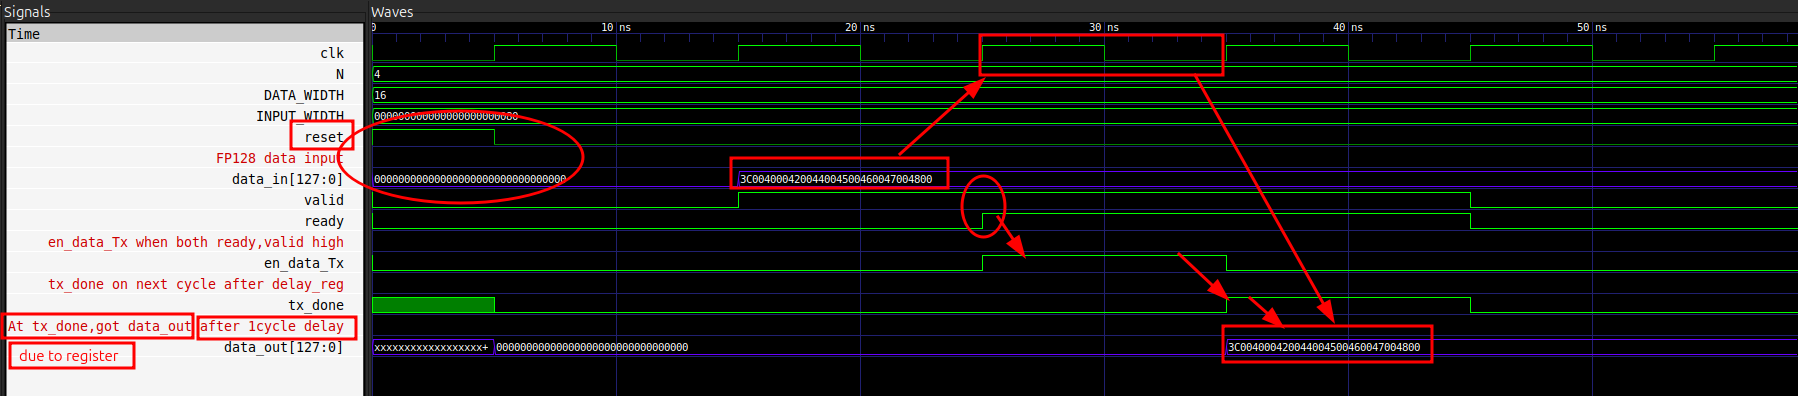
docs/simulations/rv_protocol_explained.png
