Waleed99i/chipathon-2026-systolic-ip-core/docs/top_level/chip-DRAFT.png

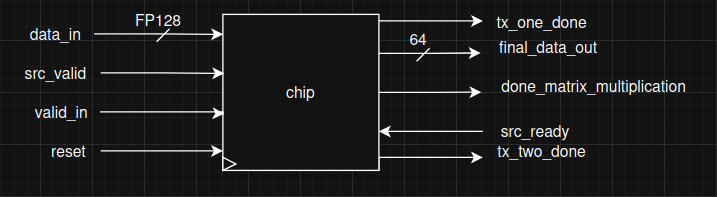
docs/top_level/chip-DRAFT.png
