Waleed99i/chipathon-2026-systolic-ip-core/docs/top_level/systolic_top.png

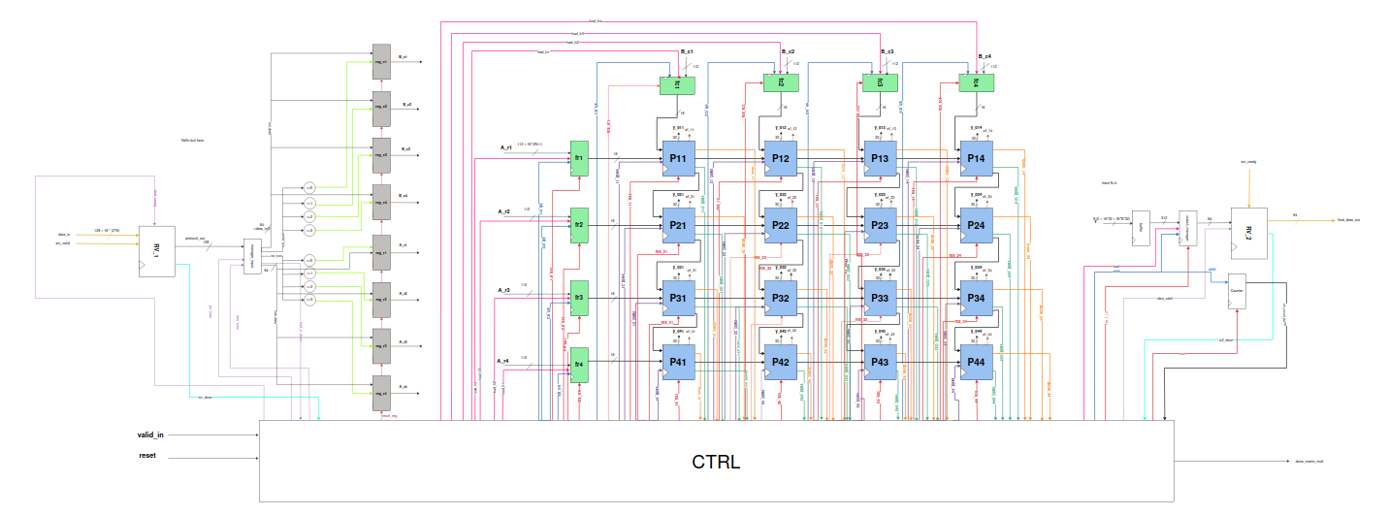
docs/top_level/systolic_top.png
