Waleed99i/chipathon-2026-systolic-ip-core/reproduce/records/FULL2_steps.txt

01-verilator-lint
02-checker-linttimingconstructs
03-checker-linterrors
04-checker-lintwarnings
05-yosys-jsonheader
06-yosys-synthesis
07-checker-yosysunmappedcells
08-checker-yosyssynthchecks
09-checker-netlistassignstatements
10-openroad-checksdcfiles
11-openroad-checkmacroinstances
12-openroad-staprepnr
13-openroad-floorplan
14-openroad-dumprcvalues
15-odb-checkmacroantennaproperties
16-odb-setpowerconnections
17-odb-manualmacroplacement
18-openroad-cutrows
19-openroad-tapendcapinsertion
20-odb-addpdnobstructions
21-openroad-generatepdn
22-odb-removepdnobstructions
23-odb-addroutingobstructions
24-openroad-globalplacementskipio
25-openroad-ioplacement
26-odb-customioplacement
27-odb-applydeftemplate
28-openroad-globalplacement
29-odb-writeverilogheader
30-checker-powergridviolations
31-openroad-stamidpnr
32-openroad-repairdesignpostgpl
33-odb-manualglobalplacement
34-openroad-detailedplacement
35-openroad-cts
36-openroad-stamidpnr-1
37-openroad-resizertimingpostcts
38-openroad-stamidpnr-2
39-openroad-globalrouting
40-openroad-checkantennas
41-openroad-repairdesignpostgrt
resolved.json
