Waleed99i/chipathon-2026-systolic-ip-core/reproduce/records/FULL3_steps.txt

01-openroad-repairdesignpostgrt
02-odb-diodesonports
03-openroad-repairantennas
04-openroad-resizertimingpostgrt
05-openroad-stamidpnr-3
06-openroad-detailedrouting
07-odb-removeroutingobstructions
08-openroad-checkantennas-1
09-checker-trdrc
10-odb-reportdisconnectedpins
11-checker-disconnectedpins
12-odb-reportwirelength
13-checker-wirelength
14-openroad-fillinsertion
15-odb-cellfrequencytables
16-openroad-rcx
17-openroad-stapostpnr
18-openroad-irdropreport
19-magic-streamout
20-klayout-streamout
21-klayout-render
22-magic-writelef
23-odb-checkdesignantennaproperties
24-klayout-xor
25-checker-xor
26-magic-drc
27-klayout-drc
28-checker-magicdrc
29-checker-klayoutdrc
30-magic-spiceextraction
31-checker-illegaloverlap
32-netgen-lvs
33-checker-lvs
34-checker-setupviolations
35-checker-holdviolations
36-checker-maxslewviolations
37-checker-maxcapviolations
38-misc-reportmanufacturability
resolved.json
