Waleed99i/chipathon-2026-systolic-ip-core/docs/results/counter.png

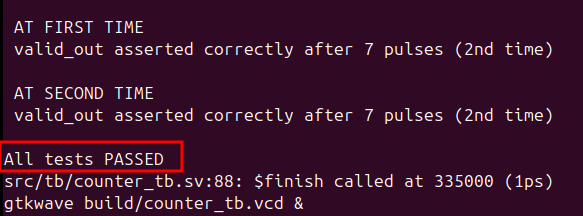
docs/results/counter.png
