Waleed99i/chipathon-2026-systolic-ip-core/docs/results/data_feeder.png

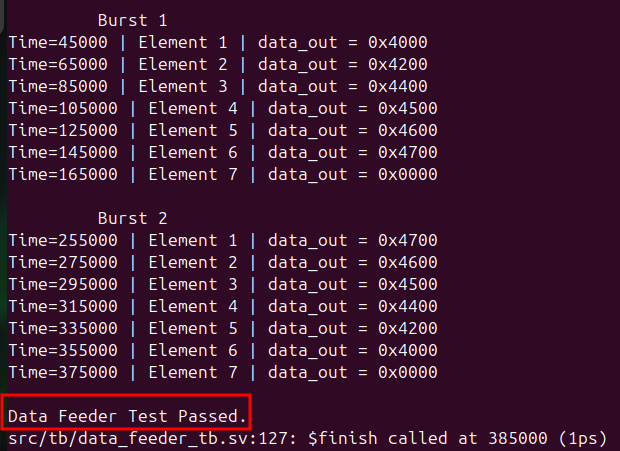
docs/results/data_feeder.png
