Waleed99i/chipathon-2026-systolic-ip-core/docs/results/input_datapath.png

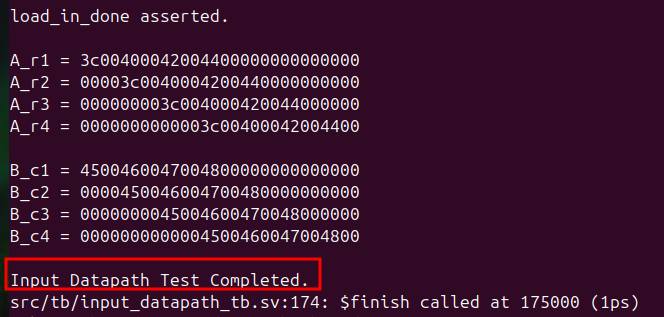
docs/results/input_datapath.png
