Waleed99i/chipathon-2026-systolic-ip-core/docs/results/mac.png

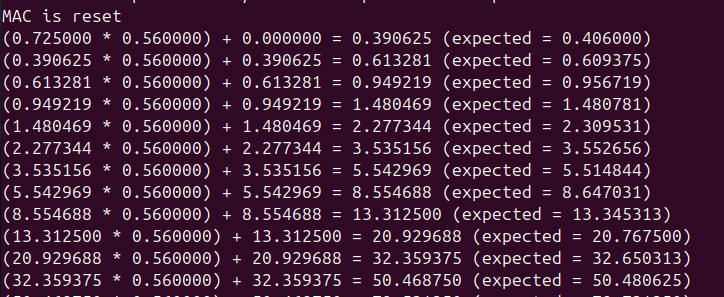
docs/results/mac.png
