Waleed99i/chipathon-2026-systolic-ip-core/docs/results/output_datapath4.png

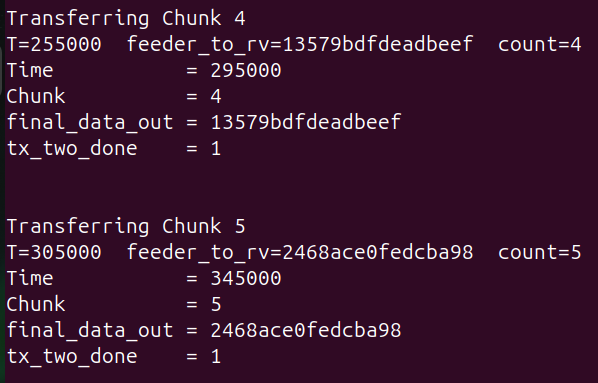
docs/results/output_datapath4.png
