Waleed99i/chipathon-2026-systolic-ip-core/docs/results/pe1.png

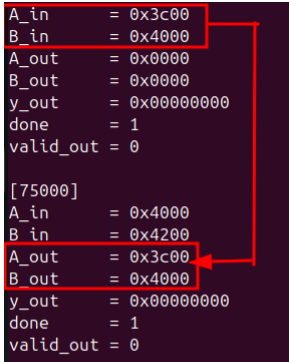
docs/results/pe1.png
