Waleed99i/chipathon-2026-systolic-ip-core/docs/results/pe2.png

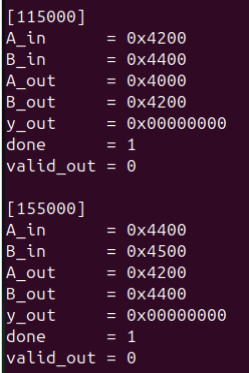
docs/results/pe2.png
