Waleed99i/chipathon-2026-systolic-ip-core/docs/results/pe3.png

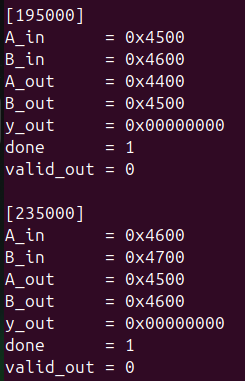
docs/results/pe3.png
