Waleed99i/chipathon-2026-systolic-ip-core/docs/results/pe4.png

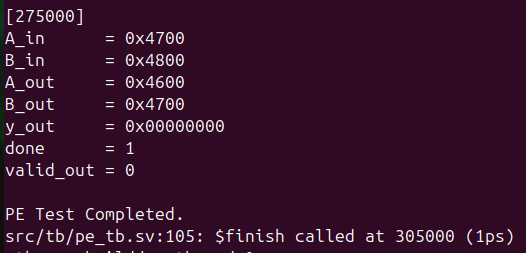
docs/results/pe4.png
