Waleed99i/chipathon-2026-systolic-ip-core/docs/results/rv_protocol.png

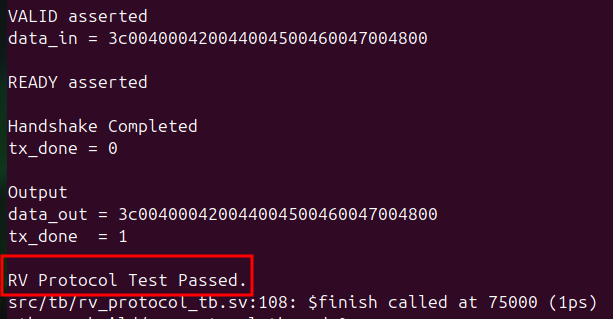
docs/results/rv_protocol.png
