Waleed99i/chipathon-2026-systolic-ip-core/src/rtl/controlled_counter.v

`timescale 1ns/1ps

module controlled_counter #(
    parameter COUNT_LIMIT = 4,
    parameter COUNT_WIDTH = (COUNT_LIMIT <= 1) ? 1 : $clog2(COUNT_LIMIT)
)(
    input clk,
    input reset,
    input enable,

    output reg count_done,
    output reg [COUNT_WIDTH-1:0] count
);

always @(posedge clk or posedge reset) begin

    if (reset) begin
        count      <= 0;
        count_done <= 1'b0;
    end

    else begin

        count_done <= 1'b0;

        if (enable) begin

            if (count == COUNT_LIMIT - 1) begin
                count      <= 0;
                count_done <= 1'b1;
            end

            else begin
                count <= count + 1'b1;
            end

        end

    end

end

endmodule
