Waleed99i/chipathon-2026-systolic-ip-core/signoff/q16_eco_full4/rtl_regression/wrapper_tb.sv

`timescale 1ns/1ps
`default_nettype none

module chip_core_tb;

    localparam NUM_INPUT_PADS  = 8;
    localparam NUM_BIDIR_PADS = 4;
    localparam NUM_ANALOG_PADS = 0;

    reg clk;
    reg rst_n;

    reg [NUM_INPUT_PADS-1:0] input_in;

    wire [NUM_BIDIR_PADS-1:0] bidir_in;
    wire [NUM_BIDIR_PADS-1:0] bidir_out;

    supply1 VDD;
    supply0 VSS;
    chip_core dut (
        .VDD(VDD), .VSS(VSS),

        .clk   (clk),
        .rst_n (rst_n),

        .input_in_0 (input_in[0]),
        .input_in_1 (input_in[1]),
        .input_in_2 (input_in[2]),
        .input_in_3 (input_in[3]),
        .input_in_4 (input_in[4]),
        .input_in_5 (input_in[5]),
        .input_in_6 (input_in[6]),
        .input_in_7 (input_in[7]),

        .output_out_0_IN  (bidir_in[0]),
        .output_out_0_OUT (bidir_out[0]),
        .output_out_1_IN  (bidir_in[1]),
        .output_out_1_OUT (bidir_out[1]),
        .output_out_2_IN  (bidir_in[2]),
        .output_out_2_OUT (bidir_out[2]),
        .output_out_3_IN  (bidir_in[3]),
        .output_out_3_OUT (bidir_out[3])
    );

    assign bidir_in = 4'b0000;


    always #5 clk = ~clk;
    reg [511:0] captured;
    integer capture_count = 0;
    integer passed_cases = 0;
    integer extra_internal_transfers = 0;

    always @(posedge clk) begin
        if (rst_n && dut.chip_core_internal_i.systolic_tx_two_done) begin
            if (capture_count < 128) begin
                captured = {captured[507:0], bidir_out};
                capture_count = capture_count + 1;
            end else begin
                // The current wrapper exposes only the first 128 nibbles.
                // Record continuing internal transfers separately; do not
                // mislabel them as additional externally valid result words.
                extra_internal_transfers = extra_internal_transfers + 1;
                if (bidir_out !== 4'b0000) $fatal(1, "Output not zero after wrapper result window");
            end
        end
    end

    task reset_dut;
        begin
            @(negedge clk);
            rst_n=0;
            input_in=0;
            captured=0;
            capture_count=0;
            repeat(3) @(posedge clk);
            @(negedge clk);
        end
    endtask

    task send_byte(input [7:0] val);
        begin
            @(negedge clk);
            input_in=val;
            rst_n=1;
            @(posedge clk);
        end
    endtask

    task send_packet(input [127:0] packet);
        integer k;
        begin
            for(k=15;k>=0;k=k-1) send_byte(packet[k*8 +: 8]);
            wait(dut.chip_core_internal_i.systolic_tx_one_done === 1'b1);
            @(posedge clk);
        end
    endtask

    task run_case(input [8*64-1:0] name, input [255:0] a, b, input [511:0] expected);
        integer r,c,k,errors;
        reg [127:0] packet;
        reg [31:0] got,want;
        begin
            reset_dut;
            for(r=0;r<4;r=r+1) begin
                packet[127:64]=a[255-r*64 -: 64];
                for(c=0;c<4;c=c+1) packet[63-c*16 -: 16]=b[255-(c*4+r)*16 -: 16];
                send_packet(packet);
            end
            wait(dut.chip_core_internal_i.systolic_done === 1'b1);
            #1;
            if(capture_count != 128) $fatal(1,"Incomplete result: %0d transfers",capture_count);
            errors=0;
            for(k=0;k<16;k=k+1) begin
                got=captured[511-k*32 -: 32];
                want=expected[511-k*32 -: 32];
                if(got !== want) begin
                    $display("MISMATCH %0s C[%0d,%0d] got=%h expected=%h",name,k/4,k%4,got,want);
                    errors=errors+1;
                end
            end
            if(errors) $fatal(1,"%0s failed: %0d elements",name,errors);
            passed_cases=passed_cases+1;
            $display("PASS: %0s (16 serialized result words)",name);
            repeat(3) @(negedge clk);
        end
    endtask

    initial begin
        clk=0; rst_n=0; input_in=0; captured=0;
        run_case("identity", 256'h3c0000000000000000003c0000000000000000003c0000000000000000003c00, 256'h3c0000000000000000003c0000000000000000003c0000000000000000003c00, 512'h00010000000000000000000000000000000000000001000000000000000000000000000000000000000100000000000000000000000000000000000000010000);
        run_case("ones", 256'h3c003c003c003c003c003c003c003c003c003c003c003c003c003c003c003c00, 256'h3c003c003c003c003c003c003c003c003c003c003c003c003c003c003c003c00, 512'h00040000000400000004000000040000000400000004000000040000000400000004000000040000000400000004000000040000000400000004000000040000);
        run_case("zero_left", 256'h0000000000000000000000000000000000000000000000000000000000000000, 256'h3c004000000044000000bc0040003c0044000000c0003c0040003c0044000000, 512'h00000000000000000000000000000000000000000000000000000000000000000000000000000000000000000000000000000000000000000000000000000000);
        run_case("zero_right", 256'h3c004000000044000000bc0040003c0044000000c0003c0040003c0044000000, 256'h0000000000000000000000000000000000000000000000000000000000000000, 512'h00000000000000000000000000000000000000000000000000000000000000000000000000000000000000000000000000000000000000000000000000000000);
        run_case("asymmetric_right_identity", 256'h3c004000000044000000bc0040003c0044000000c0003c0040003c0044000000, 256'h3c0000000000000000003c0000000000000000003c0000000000000000003c00, 512'h0001000000020000000000000004000000000000ffff000000020000000100000004000000000000fffe00000001000000020000000100000004000000000000);
        run_case("asymmetric_left_identity", 256'h3c0000000000000000003c0000000000000000003c0000000000000000003c00, 256'h3c004000000044000000bc0040003c0044000000c0003c0040003c0044000000, 512'h0001000000020000000000000004000000000000ffff000000020000000100000004000000000000fffe00000001000000020000000100000004000000000000);
        run_case("signed_asymmetric", 256'h3c004000000044000000bc0040003c0044000000c0003c0040003c0044000000, 256'h00003c004000bc00440000003c0040003c00c0000000440040003c00bc000000, 512'h0010000000050000000000000003000000000000fffd0000fffe000000060000000000000009000000070000fff4000000080000fffa00000005000000100000);
        run_case("bounded_random_0", 256'h3c00bc003c00c4004400c000c4000000bc00c4000000bc00bc00c4003c003c00, 256'h4400c000c400bc00bc003c00c4004400c00044003c00c4004400c400bc00bc00, 512'hfff300000011000000050000fffb0000001a0000ffe60000fff4000000040000fffc00000002000000150000fff2000000020000fffe000000140000ffec0000);
        run_case("bounded_random_1", 256'h40003c0040004400c40044000000c0003c0044004000bc00bc000000bc00c000, 256'hc00000003c00c0003c00c0003c00400000003c000000c000c00040004400c400, 512'hfff500000008000000130000ffea000000100000fff40000fff800000018000000040000fff80000000100000006000000060000fffb0000fff70000000c0000);
        run_case("bounded_random_2", 256'h3c0040004000c40044000000bc000000c4003c00bc00c0004400c00000004400, 256'h4400bc0000004400c4003c00400044000000000044000000bc00c0000000bc00, 512'h0000000000090000000c00000010000000100000fffc0000fffc000000100000ffee000000090000fffe0000fff6000000140000fff20000fffc000000040000);
        run_case("bounded_random_3", 256'hc000c000c000bc00bc00c400bc003c00c4003c003c00bc000000c00000004400, 256'hbc0044003c0040004400bc0040003c00440044000000c400c4004000c400bc00, 512'hfff60000fff00000fffe000000030000ffe90000fffe0000fff30000fffd000000100000fff1000000020000fff60000ffe80000000a0000ffec0000fffa0000);
        run_case("bounded_random_4", 256'h0000bc00c0004400c00040000000bc000000bc004000bc00c40040003c004000, 256'hbc003c003c004400c400c000bc00c4003c00bc00c400440040003c0000004400, 512'h000a00000008000000090000000c0000fff80000fff90000fffc0000ffec000000040000ffff0000fff900000008000000010000fff90000fff60000fff40000);
        run_case("bounded_random_5", 256'hc000bc00400040004400c0000000c0004000bc00400044000000c000c4000000, 256'hbc003c00c0004400c000bc004000440000004000440044003c00400044004400, 512'h00060000000700000012000000040000fffe000000020000ffec00000000000000040000000f000000120000001c000000040000fffa0000ffec0000ffe80000);
        run_case("bounded_random_6", 256'h3c003c003c000000c4000000440000003c00000040000000c000c000c4000000, 256'h00003c00bc00c00044003c0000000000c00000003c004000bc0000004000bc00, 512'h00020000000200000000000000000000fff80000fffc00000008000000100000fffc000000010000000100000002000000000000fffc0000fffe0000fffc0000);
        run_case("bounded_random_7", 256'h44003c003c004400c4004000c000c00040003c004000bc004000c400bc00c400, 256'hc400440000000000000044003c00bc00c0003c003c00bc00c400bc00bc004400, 512'hffde000000110000fffe0000000e0000001c0000fff8000000020000fff80000fff80000000f000000040000fff90000000a0000fffb0000ffff0000fff50000);
        run_case("q16_range_304", 256'h4c004400440044004c004400440044004c004400440044004c00440044004400, 256'h4c004c004c004c00440044004400440044004400440044004400440044004400, 512'h01300000013000000130000001300000013000000130000001300000013000000130000001300000013000000130000001300000013000000130000001300000);
        run_case("q16_range_272", 256'h4800480044000000480048004400000048004800440000004800480044000000, 256'h4c004c004c004c004c004c004c004c0044004400440044000000000000000000, 512'h01100000011000000110000001100000011000000110000001100000011000000110000001100000011000000110000001100000011000000110000001100000);
        run_case("waleed_large_matrix", 256'h4000440048004c00440048004c00400048004c00400044004c00400044004800, 256'h4c004800440040004800440040004c00440040004c00480040004c0048004400, 512'h00800000013000000110000000c4000000c400000080000001300000011000000110000000c400000080000001300000013000000110000000c4000000800000);
        run_case("negative_large_products", 256'hc000c400c800cc00c400c800cc00c000c800cc00c000c400cc00c000c400c800, 256'h4c004800440040004800440040004c00440040004c00480040004c0048004400, 512'hff800000fed00000fef00000ff3c0000ff3c0000ff800000fed00000fef00000fef00000ff3c0000ff800000fed00000fed00000fef00000ff3c0000ff800000);
        reset_dut;
        send_byte(8'h3c); send_byte(8'h00); send_byte(8'h44); send_byte(8'h00);
        run_case("reset_after_partial_packet", 256'h3c0000000000000000003c0000000000000000003c0000000000000000003c00, 256'h3c0000000000000000003c0000000000000000003c0000000000000000003c00, 512'h00010000000000000000000000000000000000000001000000000000000000000000000000000000000100000000000000000000000000000000000000010000);
        run_case("fractional_model_positive", 256'h3e00430045804780410044804680484042804540474048a044c046c048604940, 256'h408044404640482043004580478048c044c046c0486049604540474048a049a0, 512'h00508000007780000097800000bb800000618000008a800000ba800000e68000006c8000009d000000cf000000ff0000007e800000c5000000fb000001330000);
        run_case("fractional_model_negative", 256'hbe00c300c580c780c100c480c680c840c280c540c740c8a0c4c0c6c0c860c940, 256'h408044404640482043004580478048c044c046c0486049604540474048a049a0, 512'hffaf8000ff888000ff688000ff448000ff9e8000ff758000ff458000ff198000ff938000ff630000ff310000ff010000ff818000ff3b0000ff050000fecd0000);
        $display("OBSERVATION: %0d continuing internal transfers; reset before each matrix", extra_internal_transfers);
        $display("WRAPPER COMPLETE: %0d cases (20 exact, 2 approximate-model)", passed_cases);
        $finish;
    end
    initial begin #250000; $fatal(1,"Wrapper regression timeout"); end
endmodule
`default_nettype wire
