Waleed99i/chipathon-2026-systolic-ip-core/(commit log)

2026-08-08 fixed the missing pin ovf warning
    [fp16_to_q16_16_approximate_mac.v]
2026-08-11 tested another example of systolic, and printing resultant matrix too
2026-08-11 modifed chip_core_tb.sv-printed resultant matrix from chip_core
2026-08-16 modified Data Flow
2026-10-15 Add corrected Q16.16 RTL and verified physical ECO
    Update the counter, input datapath and MAC product conversion.
    Include the matching GDS, powered netlist, regression evidence and seven-cell physical ECO records.
    Local verification passes at a 45 ns clock period across nine corners:
    zero setup, hold, slew, capacitance and fanout violations;
    clean DRC, LVS and antenna checks;
    verified VDD/VSS connectivity and preserved boundary terminals.
    Integrated-chip verification and pad-aware IR/EM remain separate.
2026-10-16 Update testbenches and add passing 33-case RTL and gate-level regression
2026-10-31 Add silicon test plan, pin regression and verified checkpoint replay
